sven-simonsen/HomeAutomation/ESPBoards/AutoVenterRelayOff.jpg

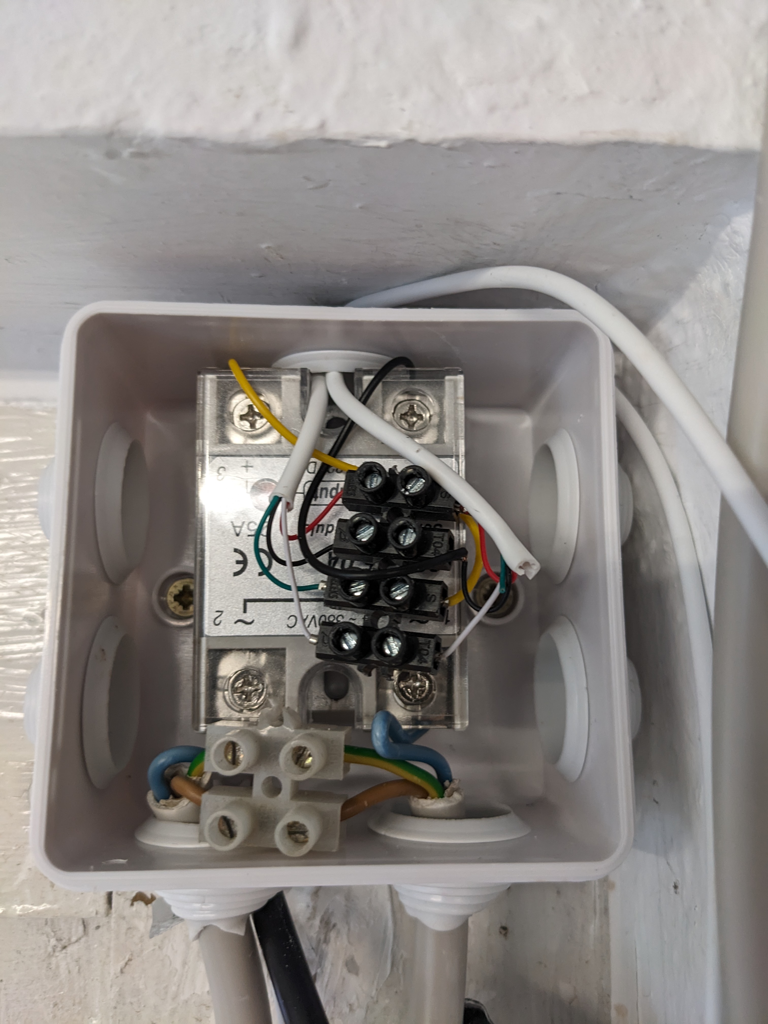
ESPBoards/AutoVenterRelayOff.jpg
