sven-simonsen/HomeAutomation/ESPBoards/AutoVenterBoard.jpg

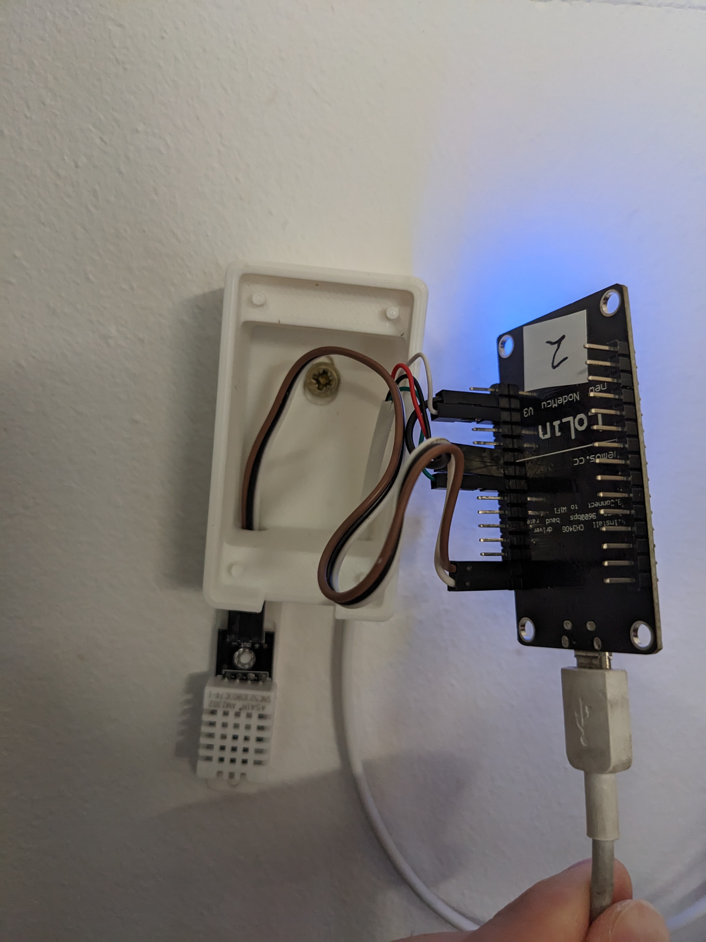
ESPBoards/AutoVenterBoard.jpg
