sven-simonsen/HomeAutomation/ESPBoards/AutoVenterRelayOn.jpg

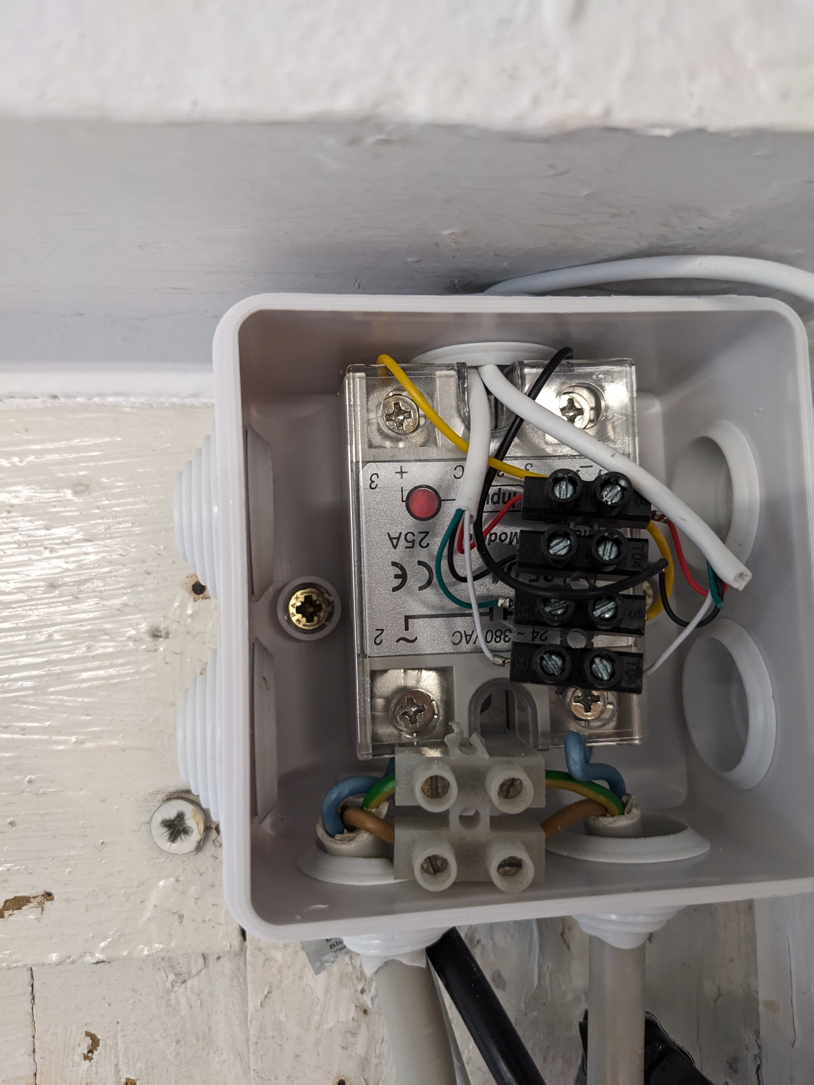
ESPBoards/AutoVenterRelayOn.jpg
