sven-simonsen/HomeAutomation/(commit log)

2025-02-22 Set of basic humidity tools without IP and other config heads
    [ESPHomeTaucontrollerPhilip.yaml]
2025-06-29 Readme Edition
    [ESPHomeTaucontrollerPhilip.yaml]
2025-06-29 Adding files
    [ESPHomeTaucontrollerPhilip.yaml]
